Elforax/Drone-Interface/Electric-design/Assembly list/Assemblage lijst Interconnect.docx

# Interconnect assemblage lijst

# Top_layer

locatie | Naam | component | Mount | aantal | Fabrikant | leverancier | Ordercode
CN3, CN4, CN7 | Terminal block 2P 5.08mm | 1729128 | THT | 3 | Phoenix Contact | Farnell | 1729128
CN5, CN8 | Terminal block 3P 5.08mm | 1729131 | THT | 2 | Phoenix Contact | Farnell | 3041451
CN6 | XT30 Male | XT30 Male | THT | 1 | Reely | Conrad | 1460539
USB1 | USB3.0 Type A Right Angle | 48405-0003 | THT | 1 | Molex | Farnell | 2401585

Note:
