Elforax/Drone-Interface/Test files/EMI System test 9-12-2019.xlsx

Sheet: Algemeen
Algemene informatie
1. | Alle testen dienen in volgorde uitgevoerd te worden
2. | Alle waardes dienen geselecteerd teworden uit de keuze lijst
 | tenzij anders aangegeven
3. | Blijf de testen uitvoeren tot het einde van het blok
4. | Na uitvoeren van de test bewaar dit bestand met de datum van de uitvoering
Legenda
 | = | Test waarde is correct/ Test blok is afgerond zonder fout(en)
 | = | Test waarde is incorrect/ Test blok is afgerond met fout(en)
 | = | Test afronding niet ingevoerd
 | = | uit te voeren test bloken
Test informatie
Datum van uitvoering |  | 2019-12-09
Naam |  | Justin Gort
Test status |  | Product voldoet

Sheet: Spannings test
Test nr. | Taak | Waarde
1 | Stel de voeding in op 12V | TRUE
2 | Zet de voeding aan | TRUE
3 | Meet de spanning van de voeding | 12.05 | V
4 | Zet de voeding uit | TRUE
Ga verder met de test
5 | Verbind de voedings kabels op de Vin | TRUE
6 | Zet de voeding aan | TRUE
7 | Meet de spanning op P1 | -0.03 | V
8 | Meet de spanning op P10 | 12.04 | V
Ga verder met de test
9 | Verbind de P10 en P3 d.m.v een kabel | TRUE
10 | Meet de spanning op P1 | 12.05 | V
11 | Meet de spanning op P23 | 4.98 | V
Ga verder met de test
Alle testen zijn succesvol voltooid

Sheet: IO Test
Test nr. | Taak | Waarde
1 | Verbind de Arduino met een PC via USB | TRUE
2 | Open de arduino software en open de Serial monitor | TRUE
3 | Power led is aan en lock led is uit | TRUE
4 | druk op de lock button | TRUE
5 | Power led is aan en lock led is aan | TRUE
6 | heeft de buzzer kort gepiept? | TRUE
Ga verder met de test
7 | Sluit D0 kort met GND | TRUE
8 | Is in de serial monitor aangegeven dat de EXT_PWM 255 is | TRUE
9 | Sluit D0 kort met GND | TRUE
10 | Is in de serial monitor aangegeven dat de EXT_PWM 0 is | TRUE
Ga verder met de test
11 | Sluit DI0 kort met GND | TRUE
12 | Is in de serial monitor aangegeven dat de EXT_PWM 255 is | TRUE
13 | Sluit DI0 kort met GND | TRUE
14 | Is in de serial monitor aangegeven dat de EXT_PWM 0 is | TRUE
Ga verder met de test
15 | Er is geen "Error" gegeven op de serial monitor | TRUE
Ga verder met de test
Alle testen zijn succesvol voltooid
