Elforax/Drone-Interface/Test files/EMI System test blank.xlsx

Sheet: Algemeen
Algemene informatie
1. | Alle testen dienen in volgorde uitgevoerd te worden
2. | Alle waardes dienen geselecteerd teworden uit de keuze lijst
 | tenzij anders aangegeven
3. | Blijf de testen uitvoeren tot het einde van het blok
4. | Na uitvoeren van de test bewaar dit bestand met de datum van de uitvoering
Legenda
 | = | Test waarde is correct/ Test blok is afgerond zonder fout(en)
 | = | Test waarde is incorrect/ Test blok is afgerond met fout(en)
 | = | Test afronding niet ingevoerd
 | = | uit te voeren test bloken
Test informatie
Datum van uitvoering
Naam
Test status |  | -

Sheet: Spannings test
Test nr. | Taak | Waarde
1 | Stel de voeding in op 12V | -
2 | Zet de voeding aan | -
3 | Meet de spanning van de voeding | 0 | V
4 | Zet de voeding uit | -
Stop met testen er is iets fout gegaan
5 | Verbind de voedings kabels op de Vin | -
6 | Zet de voeding aan | -
7 | Meet de spanning op P1 | 0 | V
8 | Meet de spanning op P10 | 0 | V
Stop met testen er is iets fout gegaan
9 | Verbind de P10 en P3 d.m.v een kabel | -
10 | Meet de spanning op P1 | 0 | V
11 | Meet de spanning op P23 | 0 | V
Stop met testen er is iets fout gegaan
Test afgebroken ergens ging iets fout

Sheet: IO Test
Test nr. | Taak | Waarde
1 | Verbind de Arduino met een PC via USB | FALSE
2 | Open de arduino software en open de Serial monitor | FALSE
3 | Power led is aan en lock led is uit | FALSE
4 | druk op de lock button | FALSE
5 | Power led is aan en lock led is aan | FALSE
6 | heeft de buzzer kort gepiept? | FALSE
Stop met testen er is iets fout gegaan
7 | Sluit D0 kort met GND | FALSE
8 | Is in de serial monitor aangegeven dat de EXT_PWM 255 is | FALSE
9 | Sluit D0 kort met GND | FALSE
10 | Is in de serial monitor aangegeven dat de EXT_PWM 0 is | FALSE
Stop met testen er is iets fout gegaan
11 | Sluit DI0 kort met GND | FALSE
12 | Is in de serial monitor aangegeven dat de EXT_PWM 255 is | FALSE
13 | Sluit DI0 kort met GND | FALSE
14 | Is in de serial monitor aangegeven dat de EXT_PWM 0 is | FALSE
Stop met testen er is iets fout gegaan
15 | Er is geen "Error" gegeven op de serial monitor | FALSE
Stop met testen er is iets fout gegaan
Test afgebroken ergens ging iets fout
