Elforax/Drone-Interface/Software-Design/Software design.pdf

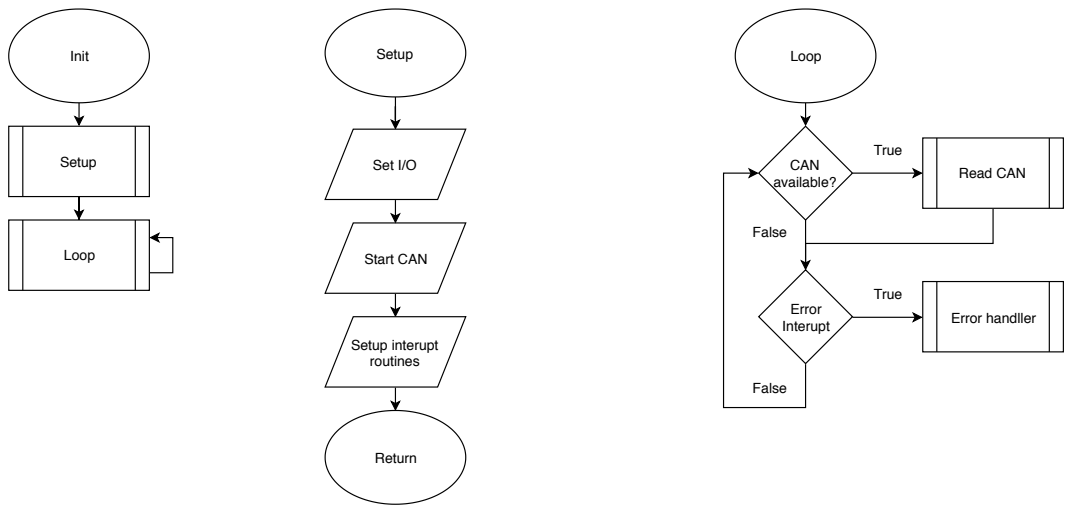
[picture p15: page 1]
Init; Setup; Loop; Start CAN; Set I/O; Return; Error handller; Setup interupt routines; True; False; Error Interupt

Read CAN CAN
available?

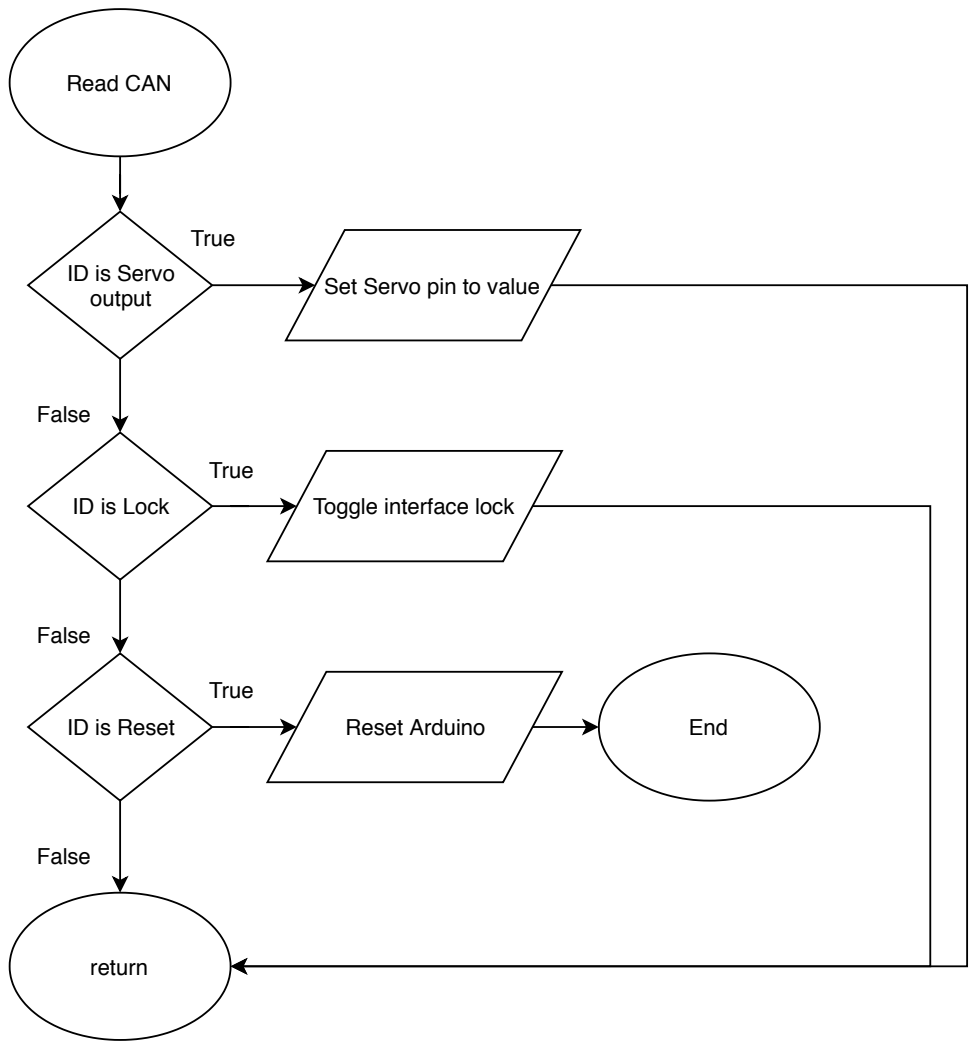
[picture p16: page 2]
Read CAN; False; True; return; Reset Arduino; End

ID is Servo
output

Set Servo pin to value

ID is Lock

Toggle interface lock

ID is Reset

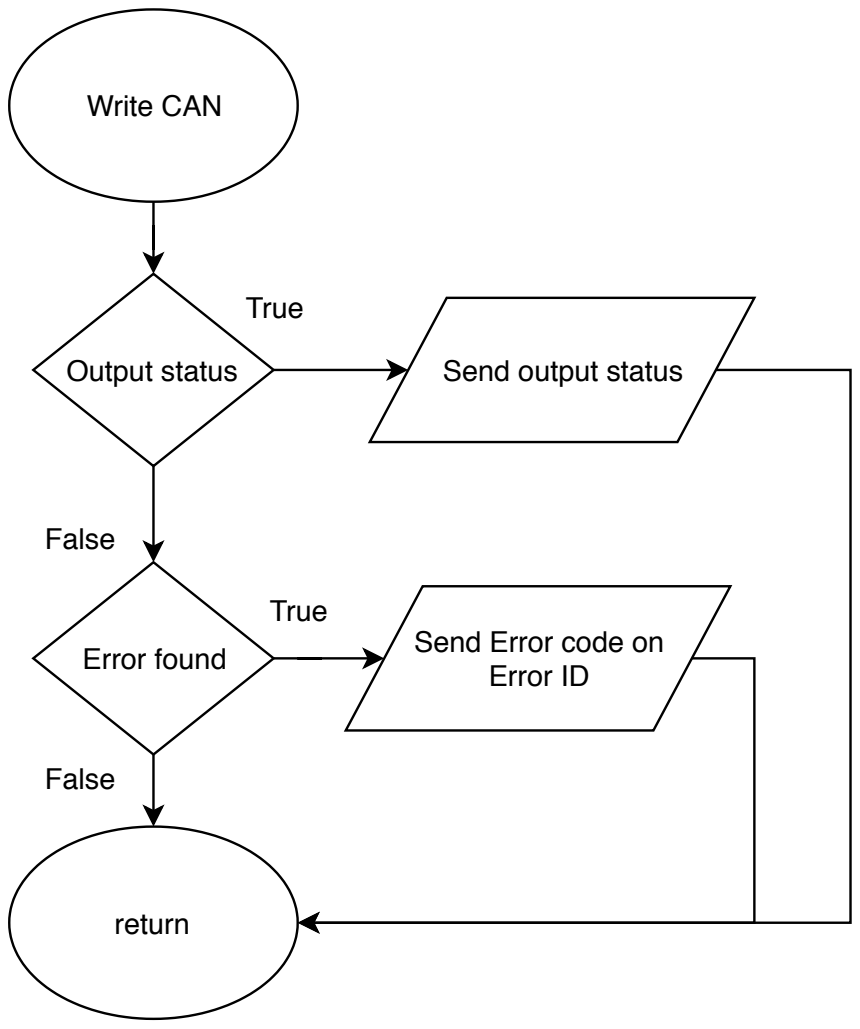
[picture p17: page 3]
Write CAN; Output status; False; True; return; Error found

Send output status

Send Error code on
Error ID

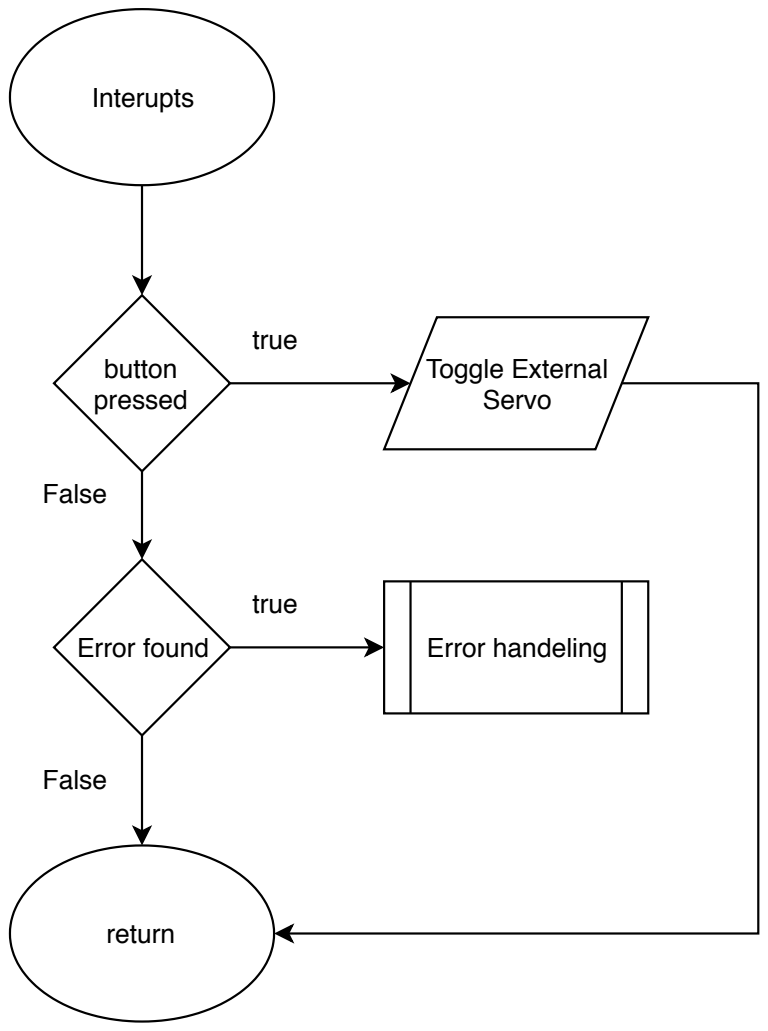
[picture p18: page 4]
Interupts; button pressed; true; Servo; Error found; return; False

Toggle External

Error handeling

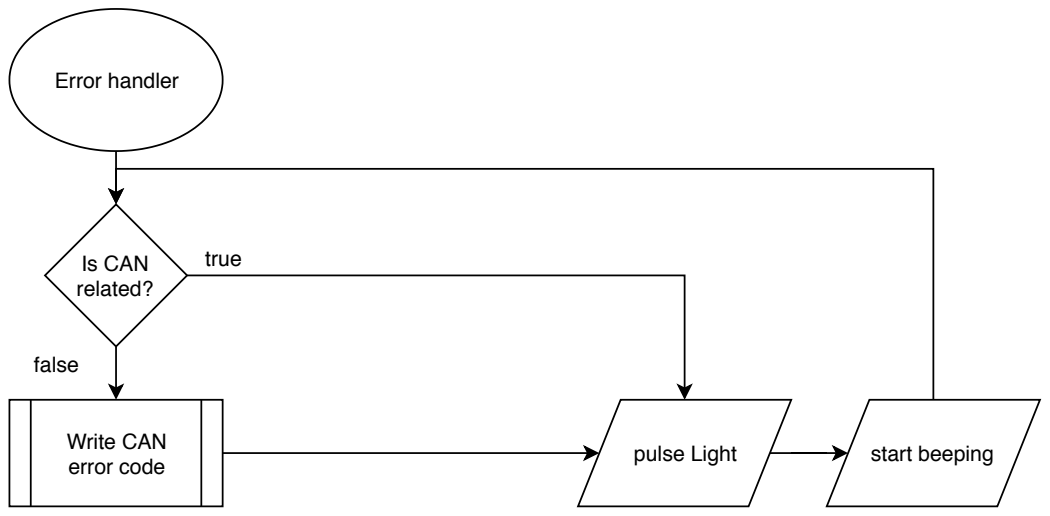
[picture p19: page 5]
Error handler; Is CAN related?; pulse Light; start beeping Write CAN; error code; true; false
