Elforax/Drone-Interface/Electric-design/Schematics/Controller.pdf

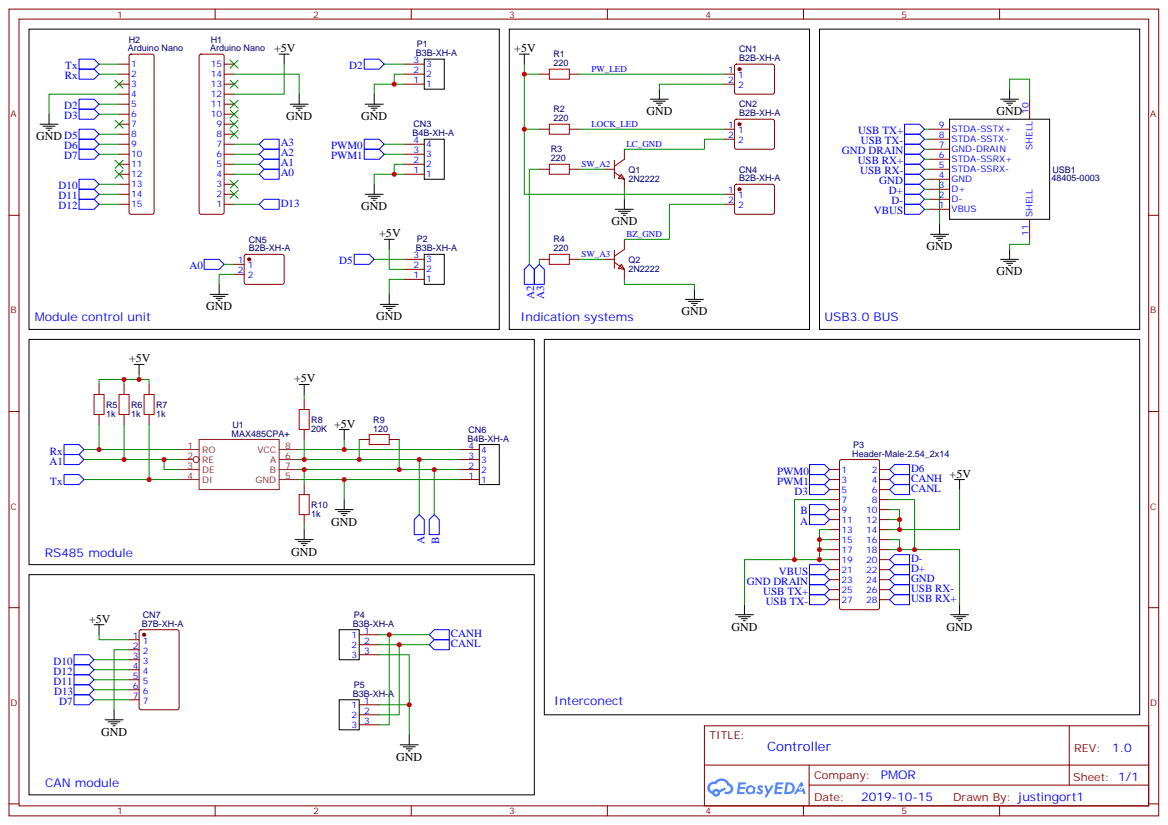
[picture p20: page 1]
