Elforax/Drone-Interface/Electric-design/Schematics/Interconnect-Backplane.pdf

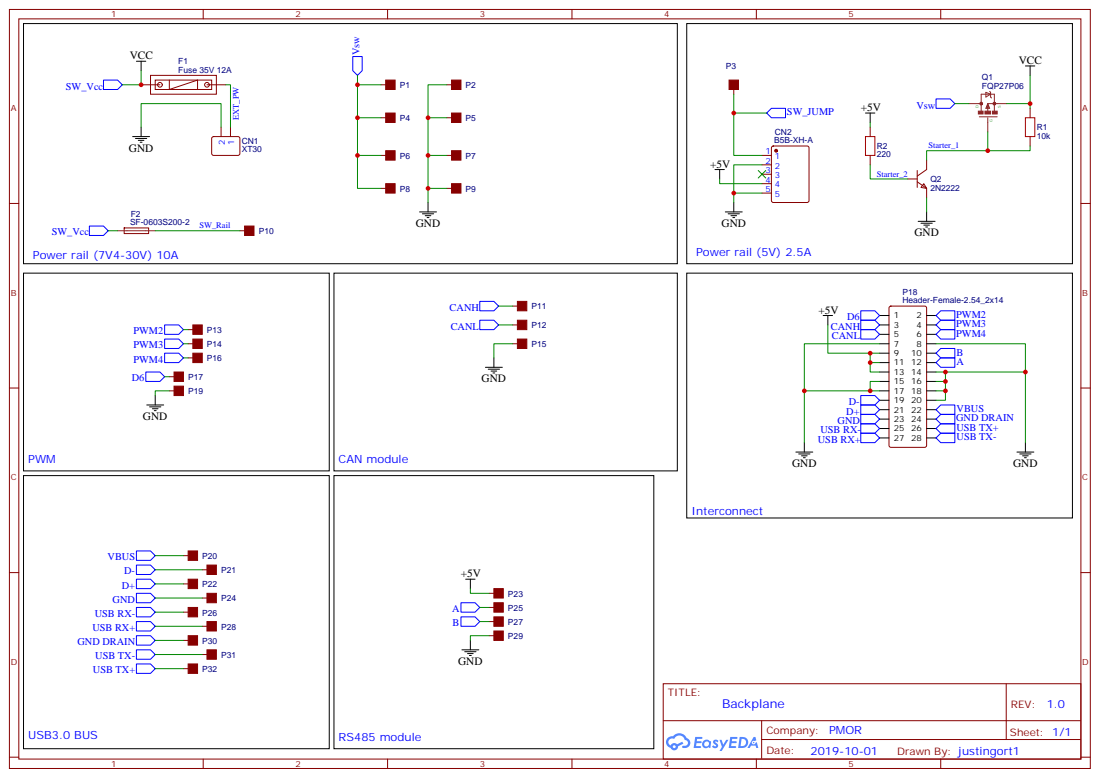
[picture p21: page 1]

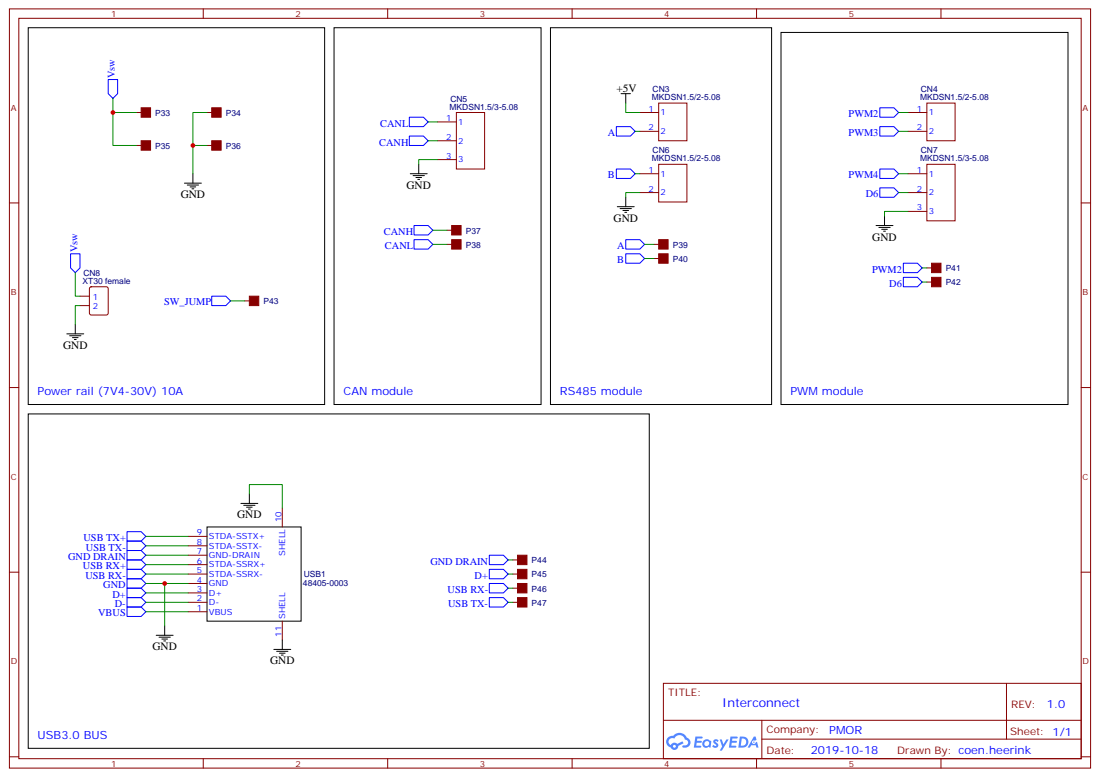
[picture p22: page 2]

Drawn By: coen.heerink
