Elforax/Drone-Interface/(commit log)

2019-12-06 Create Spannings test.xlsx
    [Spannings test.xlsx]
2019-12-09 Edit Spannings test
    [Spannings test.xlsx]
2019-12-09 Edit name
    Spannings test changed to EMI System test
    [EMI System test.xlsx]
2019-12-09 Added test results
    [EMI System test 9-12-2019.xlsx, EMI System test blank.xlsx]
